NextGen-Environmental-Sensor-Lab/NGENS-Sap-Flow-Sensor-V2.1-bigbox/README.md

<small>

**SAPFLOW SENSOR V2.1 - BIGGER BOX, CIRCULAR 10-PIN CONNECTOR, NEW CPU AND PCB, UPDATED CODE**

**[Setup Procedure](./Sapflow%20bigbox%20setup%20procedure.md)**

| |  |  |  |  |  |  |
| :---- | :---- | ----- | ----- | ----- | ----- | :---- |
| **Last updated: 1-26-26** | **PRICE BREAK POINT: 25** |  |  |  |  |  |
| **Designator** | **Part** | **Supplier** | **q/ system** | **$ per part** | **$ per sensor** | **link** |
| JST-PH 10pin with cable | 2 x 20-pack, tot 40 | Amazon | 1 | 1.13 | 1.13 | [Amazon.com 40Pcs jst ph 2.0 Connectors 10 pin w 20pcs Mini](https://www.amazon.com/40Pcs-Connectors-Connector-Include-Female/dp/B0DMZLGB5D?th=1) |
| Lithium CR1220 3 V batteries | 15-pack, tot 30 | Amazon | 1 | 0.40 | 0.40 | [POWEROWL CR1220 Battery (15-Pack)](https://www.amazon.com/POWEROWL-Capacity-Battery-Batteries-Leak-Free/dp/B09877NBQG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) |
| Li CR2032 battery | 50-pack | Amazon | 1 | 0.32 | 0.32 | [Amazon.com: Granicell CR2032 ...](https://www.amazon.com/dp/B0DKXJCMSZ?ref=fed_asin_title) |
| Battery clip connector 9v-type | 4 count, with jst-ph, tot 32 | Amazon | 1 | 1.60 | 1.60 | [amazon.com OZXNO 4 Pcs 9V Battery Snap to PH 2.0](https://www.amazon.com/gp/product/B0BVFWRJDS/ref=ox_sc_act_title_1?smid=A1TOK94TYI9XUY&th=1) |
| M4 x 8mm pcb screws | 3x 50-pack | Amazon | 4 | 0.58 | 2.30 | [amazon screws](https://www.amazon.com/dp/B0FH1WL1YG?ref=fed_asin_title&th=1) |
| 32gb pny micro sd | 3 packs of 5, 15 tot | Amazon | 0 | 7.34 | 0.00 |  |
| 32gb micro sd card | 5 packs of 3, 15 tot | B\&H | 0 | 11.66 | 0.00 | [PNY 32GB Elite UHS-I microSDHC Memory Card P-SDU32X2U185EL-GE](https://www.bhphotovideo.com/c/product/1313832-REG/pny_technologies_p_sdu32x2u185el_ge_flash_memory_card_microsdhc.html) |
| 32gb microsd combined | add above two | B\&H amaz | 1 | 9.50 | 9.50 |  |
| Microcontroller | Feather RP2040 Adalogger | Digikey | 1 | 14.95 | 14.95 | [https://learn.adafruit.com/assets/139935](https://learn.adafruit.com/assets/139935) |
| header female 12 pos (feather) | PPTC121LFBN-RC | Digikey | 1 | 0.54 | 0.54 | [PPTC121LFBN-RC Sullins Connector Solutions](https://www.digikey.com/en/products/detail/sullins-connector-solutions/PPTC121LFBN-RC/807231) |
| header female 16 pos (feather) | PPTC161LFBN-RC | Digikey | 1 | 0.56 | 0.56 | [PPTC161LFBN-RC Sullins Connector Solutions | Headers, Receptacles, Female Sockets | DigiKey](https://www.digikey.com/en/products/detail/sullins-connector-solutions/PPTC161LFBN-RC/810154) |
| JST-PH 2pin vertical |  | Digikey | 1 | 0.11 | 0.11 | [B2B-PH-K-S JST Sales America Inc. | Headers, Male Pins | DigiKey](https://www.digikey.com/en/products/detail/jst-sales-america-inc/B2B-PH-K-S/926611) |
| 10 Pos circ Conn Plug Female | BU-10BFFA-LL7001 | Digikey | 1 | 11.44 | 11.44 | [digikey.com BU-10BFFA-LL7001](https://www.digikey.com/en/products/detail/amphenol-ltw/BU-10BFFA-LL7001/7102699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) |
| Shipping digikey |  | Digikey | 1 | 0.23 | 0.23 |  |
| 10 Pos Cir Conn Male | BU-10PMMS-LC7001 | Digikey | 0 | 5.30 | 0.00 | [digikey.com BU-10PMMS-LC7001](https://www.digikey.com/en/products/detail/amphenol-ltw/BU-10PMMS-LC7001/7102698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) |
| 10 Pos Cir Conn Male | BU-10PMMS-LC7001 | Newark | 0 | 8.91 | 0.00 | [newark.com bu-10pmms-lc7001](https://www.newark.com/amphenol-ltw/bu-10pmms-lc7001/circular-connector-plug-10-position/dp/47W9551) |
| 10 Pos cir conn combined digikey and newark |  |  | 1 | 7.34 | 7.34 |  |
| PCBA JLBPCB | pcba 30 units | JLBPCB | 1 | 23.12 | 23.12 |  |
| Battery Holder | 10x AA battery holder | Newark | 1 | 2.09 | 2.09 | [28-12573 PRO POWER, Battery Holder, Snap Fit, AA X 10 | Newark Electronics](https://www.newark.com/pro-power/28-12573/battery-sizes-accepted-aa/dp/27W3409) |
| Polycase WH-10-01 | With hole for connector | Polycase | 1 | 24.95 | 24.95 | [https://www.polycase.com/wh-10](https://www.polycase.com/wh-02) |
| Ni-MH 1.2V 2500mAh AA batt | 500-pack \+ 100-pack, tot 600 | Tenergy | 20 | 1.42 | 28.40 | [https://www.eblofficial.com/products/rechargeable-nimh-aa-battery?variant=40668336455762](https://www.eblofficial.com/products/rechargeable-nimh-aa-battery?variant=40668336455762) |
</small>
