NextGen-Environmental-Sensor-Lab/NGENS-Sap-Flow-Sensor-V2.1-bigbox/KiCad_PCB/Assembly_Instructions.md

# Version 2.1 Assembly Instructions

## Required parts

- One Adafruit Feather M0 Adalogger
- One 12-pin female header
- One 12-pin male header
- One 16-pin female header
- One 16-pin male header
- One CR2032 coil cell
- One 9V-style battery clip with leads
- One 10-pin JST PH cable assembly
- One set of waterproof connector

### Battery connector options

Option 1: Use a battery clip with only wires on the other end, and solder it to the board.

Option 2: Use a battery clip with a JST connector on the other end, and a JST connector on the board.

### USB power parts

There are two ways to power the microcontroller -- through the USB port, or directly from the board. If you are using USB power, you will need these additional parts.

- One 2-pin push terminal
- One micro USB "pig-tail"

## Instructions

### ID

Each board is assigned an ID. On the back is a grid of solder jumpers, which are used to tell the microcontroller which board it is on. The ID will be included in the data file.

1. Choose the next sequential ID from the database (TBD).
2. Write the ID in the provided space on both the front and back of the board with a permanent marker.
3. Solder a blob of solder between the two contacts of the corresponding solder jumper pads.

### Power configuration

For USB power input, solder a blob of solder across JP43.

For direct power input, solder a blob of solder across JP41 and JP42.
