NextGen-Environmental-Sensor-Lab/NGENS-Sap-Flow-Sensor-V2.1-bigbox/KiCad_PCB/pcb_V2.1bigbox.pdf

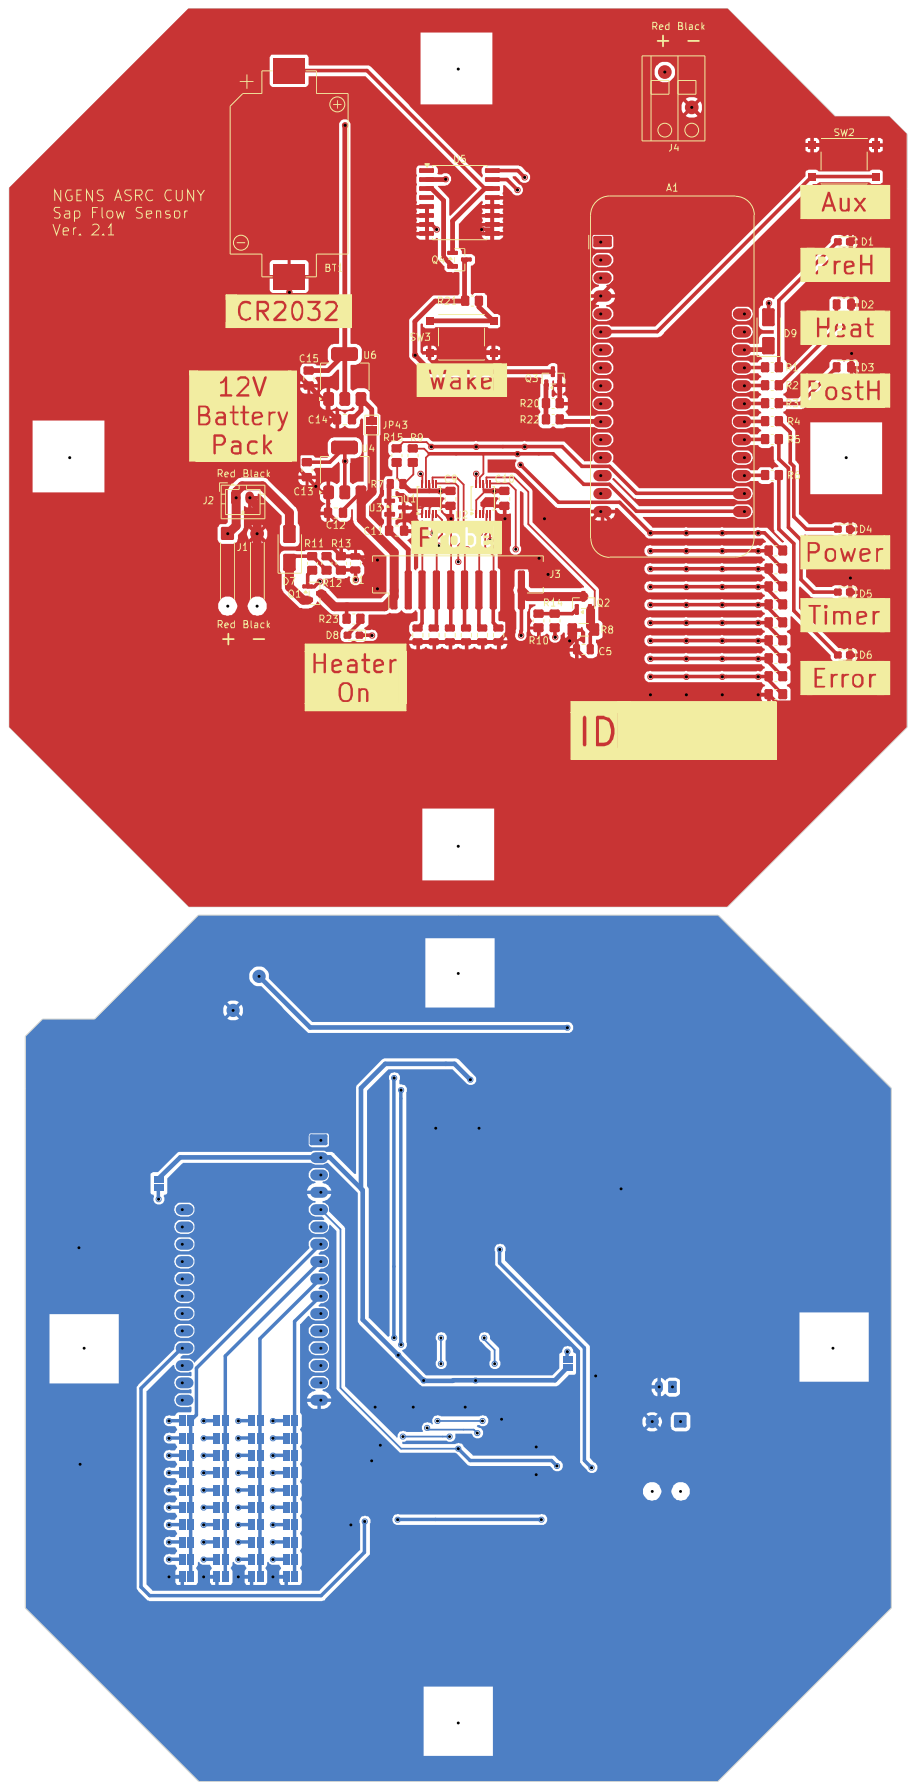
[picture p6: page 1]
