NextGen-Environmental-Sensor-Lab/NGENS-Sap-Flow-Sensor-V2.1-bigbox/KiCad_PCB/SFS.kicad_pcb

## KiCad design KiCad_PCB/SFS.kicad_pcb (2026-06-18)

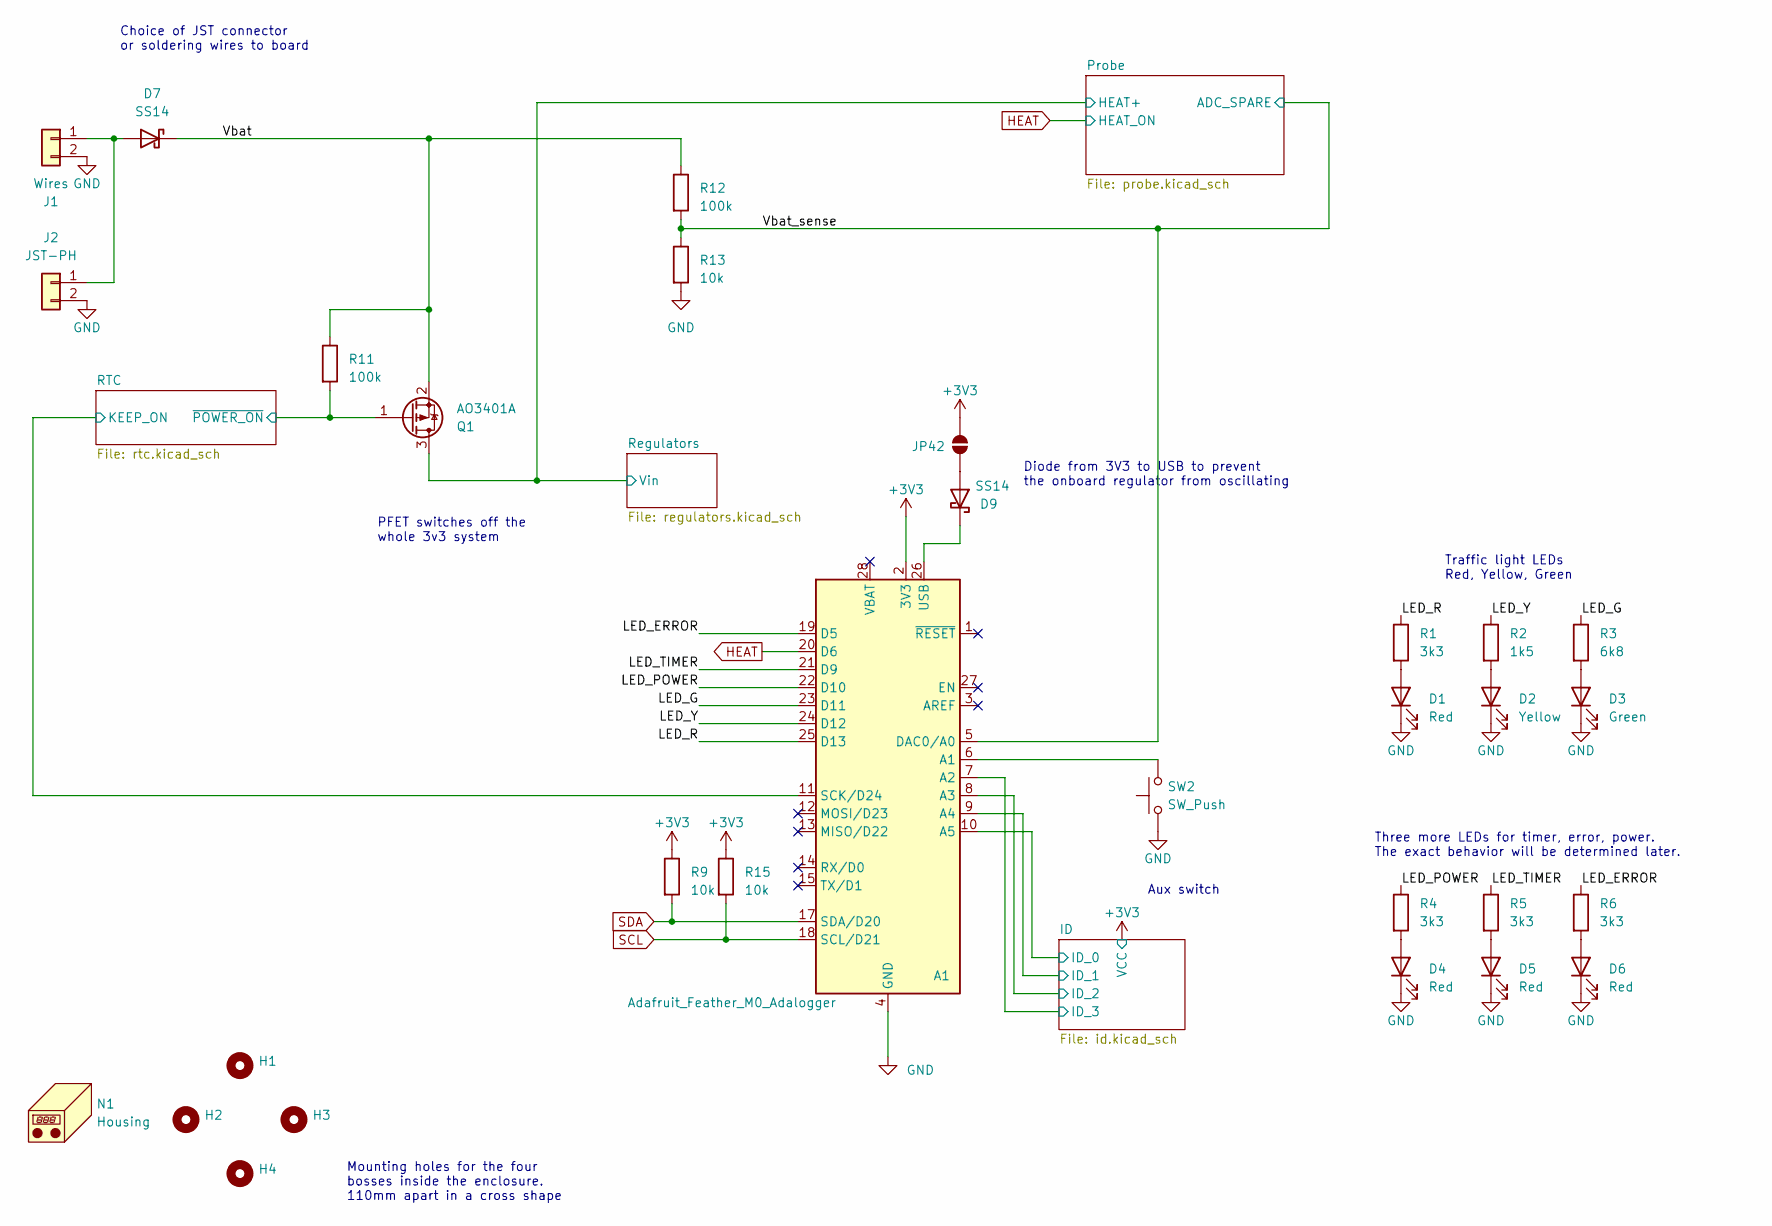
[picture p7: schematic SFS.kicad_sch]

Parts:
A1: Adafruit_Feather_M0_Adalogger; Adafruit_Feather
D1, D4, D5, D6: Red; LED_0603_1608Metric_Pad1.05x0.95mm_HandSolder; LCSC C2286
D2: Yellow; LED_0805_2012Metric_Pad1.15x1.40mm_HandSolder; LCSC C2296
D3: Green; LED_0805_2012Metric_Pad1.15x1.40mm_HandSolder; LCSC C2297
D7, D9: SS14; D_SMA; LCSC C2480
H1, H2, H3, H4: MountingHole; MountingHole_4.3mm_M4
J1: Wires; SolderWire-0.25sqmm_1x02_P4.2mm_D0.65mm_OD1.7mm_Relief
J2: JST-PH; JST_PH_B2B-PH-K_1x02_P2.00mm_Vertical
JP42: SolderJumper_2_Open; SolderJumper-2_P1.3mm_Open_Pad1.0x1.5mm
N1: Housing; Enclosure_WH-10
Q1: AO3401A; SOT-23; LCSC C15127
R1, R4, R5, R6: 3k3; R_0805_2012Metric_Pad1.20x1.40mm_HandSolder; LCSC C26010
R2: 1k5; R_0805_2012Metric_Pad1.20x1.40mm_HandSolder; LCSC C4310
R3: 6k8; R_0805_2012Metric_Pad1.20x1.40mm_HandSolder; LCSC C17772
R9, R13, R15: 10k; R_0805_2012Metric_Pad1.20x1.40mm_HandSolder; LCSC C17414
R11, R12: 100k; R_0805_2012Metric_Pad1.20x1.40mm_HandSolder; LCSC C149504
SW2: SW_Push; SW_Push_1P1T_NO_6x6mm_H9.5mm_C2837532; LCSC C2837532

Connections:
+3V3: A1.2 (3V3), JP42.2 (B), R9.1, R15.1; also elsewhere on the board
/ID/ID_0: A1.10 (A5); also elsewhere on the board
/ID/ID_1: A1.9 (A4); also elsewhere on the board
/ID/ID_2: A1.8 (A3); also elsewhere on the board
/ID/ID_3: A1.7 (A2); also elsewhere on the board
/LED_ERROR: A1.19 (D5), R6.1
/LED_G: A1.23 (D11), R3.1
/LED_POWER: A1.22 (D10), R4.1
/LED_R: A1.25 (D13), R1.1
/LED_TIMER: A1.21 (D9), R5.1
/LED_Y: A1.24 (D12), R2.1
/Probe/HEAT+: Q1.3 (D); also elsewhere on the board
/RTC/KEEP_ON: A1.11 (SCK/D24); also elsewhere on the board
/RTC/~POWER_ON: Q1.1 (G), R11.2; also elsewhere on the board
/Vbat: D7.1 (K), Q1.2 (S), R11.1, R12.1
/Vbat_sense: A1.5 (DAC0/A0), R12.2, R13.1; also elsewhere on the board
GND: A1.4 (GND), A1.16 (GND), D1.1 (K), D2.1 (K), D3.1 (K), D4.1 (K), D5.1 (K), D6.1 (K), J1.2, J2.2, R13.2, SW2.1; also elsewhere on the board
HEAT: A1.20 (D6); also elsewhere on the board
unnamed: A1.6 (A1), SW2.2
unnamed: A1.26 (USB), D9.1 (K)
unnamed: D1.2 (A), R1.2
unnamed: D2.2 (A), R2.2
unnamed: D3.2 (A), R3.2
unnamed: D4.2 (A), R4.2
unnamed: D5.2 (A), R5.2
unnamed: D6.2 (A), R6.2
unnamed: D7.2 (A), J1.1, J2.1
unnamed: D9.2 (A), JP42.1 (A)
SCL: A1.18 (SCL/D21), R15.2; also elsewhere on the board
SDA: A1.17 (SDA/D20), R9.2; also elsewhere on the board

Notes on the sheet:
Mounting holes for the four bosses inside the enclosure. 110mm apart in a cross shape
PFET switches off the whole 3v3 system
Traffic light LEDs Red, Yellow, Green
Diode from 3V3 to USB to prevent the onboard regulator from oscillating
Three more LEDs for timer, error, power. The exact behavior will be determined later.
Aux switch
Choice of JST connector or soldering wires to board

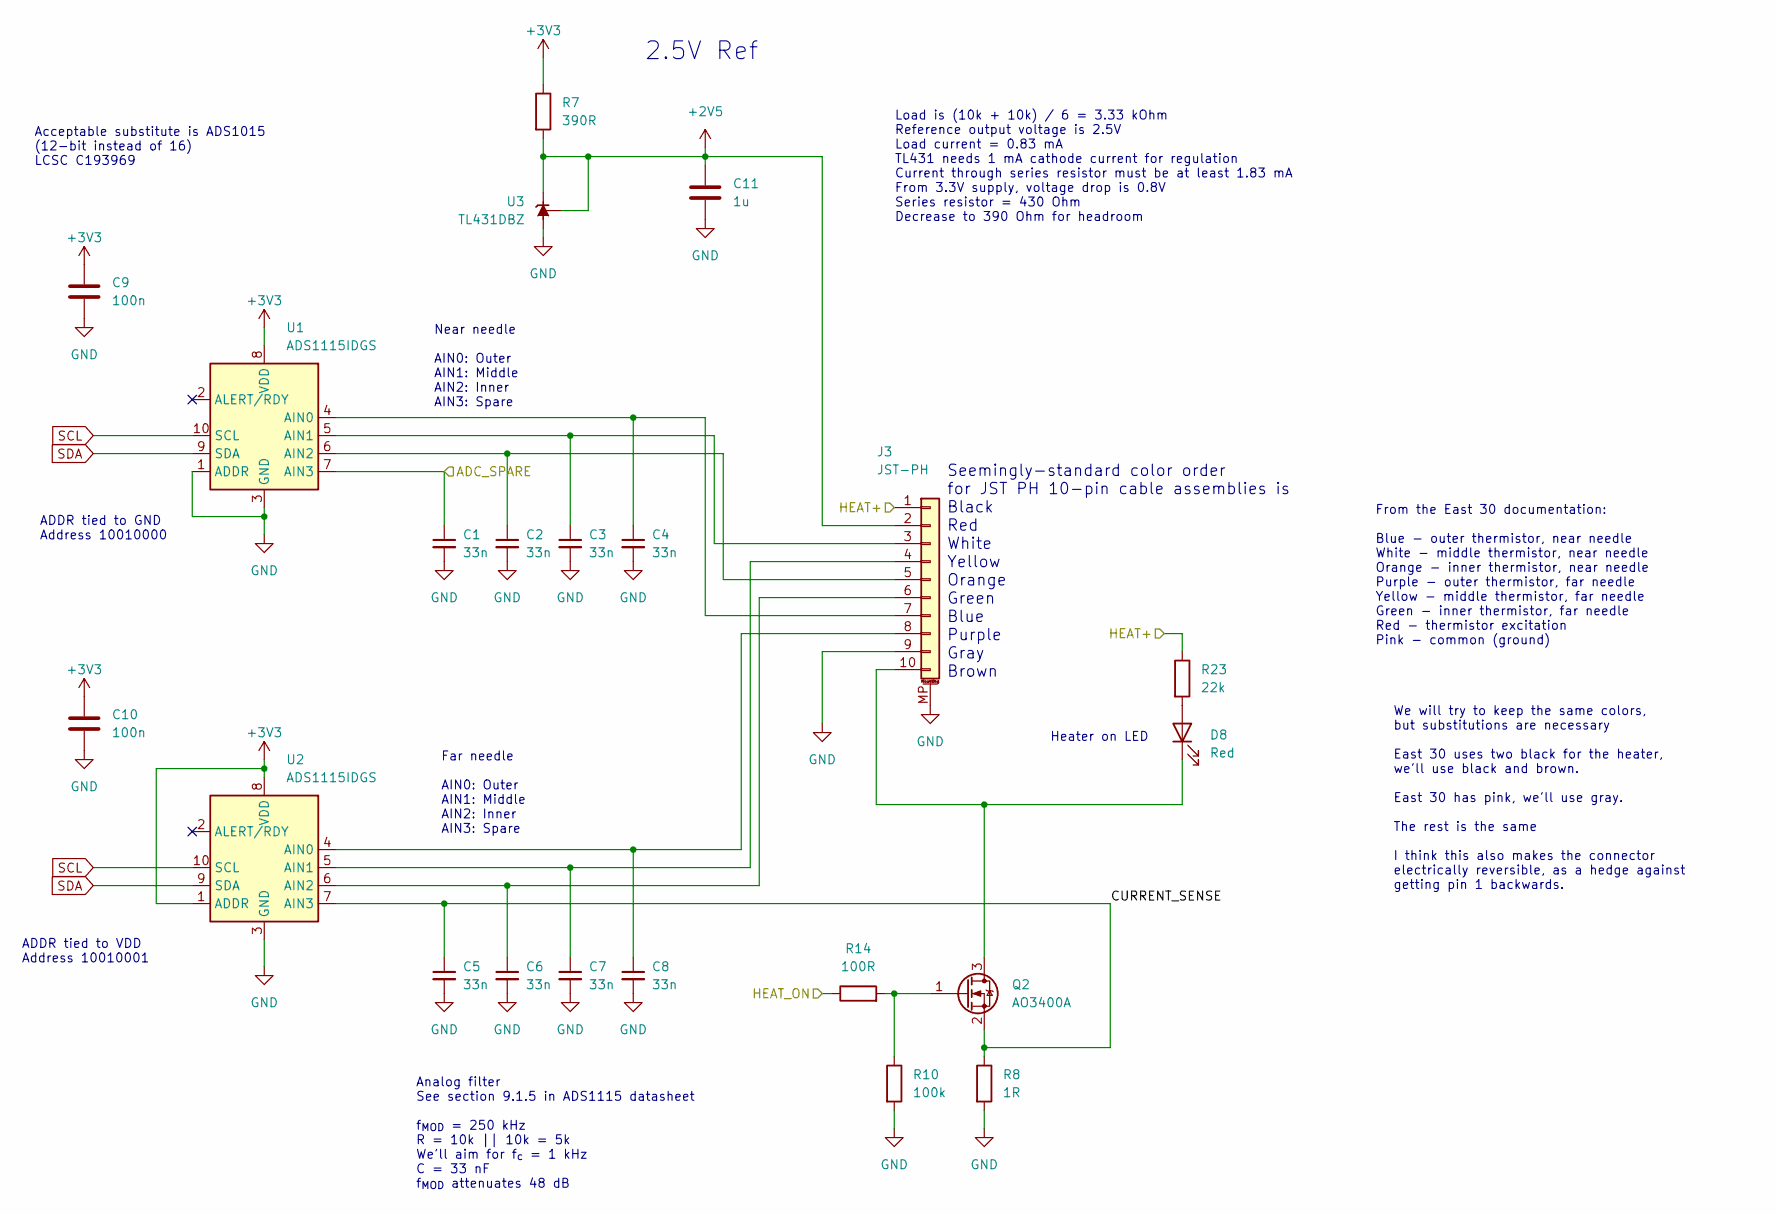
[picture p8: schematic probe.kicad_sch]

Parts:
C1, C2, C3, C4, C5, C6, C7, C8: 33n; C_0805_2012Metric; LCSC C1739
C9, C10: 100n; C_0805_2012Metric_Pad1.18x1.45mm_HandSolder; LCSC C49678
C11: 1u; C_0805_2012Metric_Pad1.18x1.45mm_HandSolder; LCSC C28323
D8: Red; LED_0603_1608Metric_Pad1.05x0.95mm_HandSolder; LCSC C2286
J3: JST-PH; JST_PH_B10B-PH-SM4-TB_1x10-1MP_P2.00mm_Vertical; LCSC C5292583
Q2: AO3400A; SOT-23; LCSC C20917
R7: 390R; R_0805_2012Metric; LCSC C17655
R8: 1R; R_1206_3216Metric_Pad1.30x1.75mm_HandSolder; LCSC C17928
R10: 100k; R_0805_2012Metric_Pad1.20x1.40mm_HandSolder; LCSC C149504
R14: 100R; R_0805_2012Metric_Pad1.20x1.40mm_HandSolder; LCSC C17408
R23: 22k; R_0805_2012Metric_Pad1.20x1.40mm_HandSolder; LCSC C17560
U1, U2: ADS1115IDGS; TSSOP-10_3x3mm_P0.5mm; LCSC C2868291
U3: TL431DBZ; SOT-23; LCSC C3113

Connections:
+2V5: C11.1, J3.2, R7.2, U3.1 (K), U3.2 (REF)
+3V3: C9.1, C10.1, R7.1, U1.8 (VDD), U2.1 (ADDR), U2.8 (VDD); also elsewhere on the board
/Probe/CURRENT_SENSE: C5.1, Q2.2 (S), R8.1, U2.7 (AIN3)
/Probe/HEAT+: J3.1, R23.1; also elsewhere on the board
/Vbat_sense: C1.1, U1.7 (AIN3); also elsewhere on the board
GND: C1.2, C2.2, C3.2, C4.2, C5.2, C6.2, C7.2, C8.2, C9.2, C10.2, C11.2, J3.9, J3.MP (MountPin), R8.2, R10.2, U1.1 (ADDR), U1.3 (GND), U2.3 (GND), U3.3 (A); also elsewhere on the board
HEAT: R14.1; also elsewhere on the board
unnamed: D8.2 (A), R23.2
unnamed: D8.1 (K), J3.10, Q2.3 (D)
unnamed: C3.1, J3.3, U1.5 (AIN1)
unnamed: C7.1, J3.4, U2.5 (AIN1)
unnamed: C2.1, J3.5, U1.6 (AIN2)
unnamed: C6.1, J3.6, U2.6 (AIN2)
unnamed: C4.1, J3.7, U1.4 (AIN0)
unnamed: C8.1, J3.8, U2.4 (AIN0)
unnamed: Q2.1 (G), R10.1, R14.2
SCL: U1.10 (SCL), U2.10 (SCL); also elsewhere on the board
SDA: U1.9 (SDA), U2.9 (SDA); also elsewhere on the board

Notes on the sheet:
ADDR tied to GND Address 10010000
Acceptable substitute is ADS1015 (12-bit instead of 16) LCSC C193969
Far needle AIN0: Outer AIN1: Middle AIN2: Inner AIN3: Spare
Near needle AIN0: Outer AIN1: Middle AIN2: Inner AIN3: Spare
2.5V Ref
Heater on LED
Load is (10k + 10k) / 6 = 3.33 kOhm Reference output voltage is 2.5V Load current = 0.83 mA TL431 needs 1 mA cathode current for regulation Current through series resistor must be at least 1.83 mA From 3.3V supply, voltage drop is 0.8V Series resistor = 430 Ohm Decrease to 390 Ohm for headroom
From the East 30 documentation: Blue - outer thermistor, near needle White - middle thermistor, near needle Orange - inner thermistor, near needle Purple - outer thermistor, far needle Yellow - middle thermistor, far needle Green - inner thermistor, far needle Red - thermistor excitation Pink - com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
We will try to keep the same colors, but substitutions are necessary East 30 uses two black for the heater, we'll use black and brown. East 30 has pink, we'll use gray. The rest is the same I think this also makes the connector electrically reversible, as a hedge against getting pin 1 backwards.
Analog filter See section 9.1.5 in ADS1115 datasheet f_{MOD} = 250 kHz R = 10k || 10k = 5k We'll aim for f_{c} = 1 kHz C = 33 nF f_{MOD} attenuates 48 dB
Seemingly-standard color order for JST PH 10-pin cable assemblies is Black Red White Yellow Orange Green Blue Purple Gray Brown
ADDR tied to VDD Address 10010001

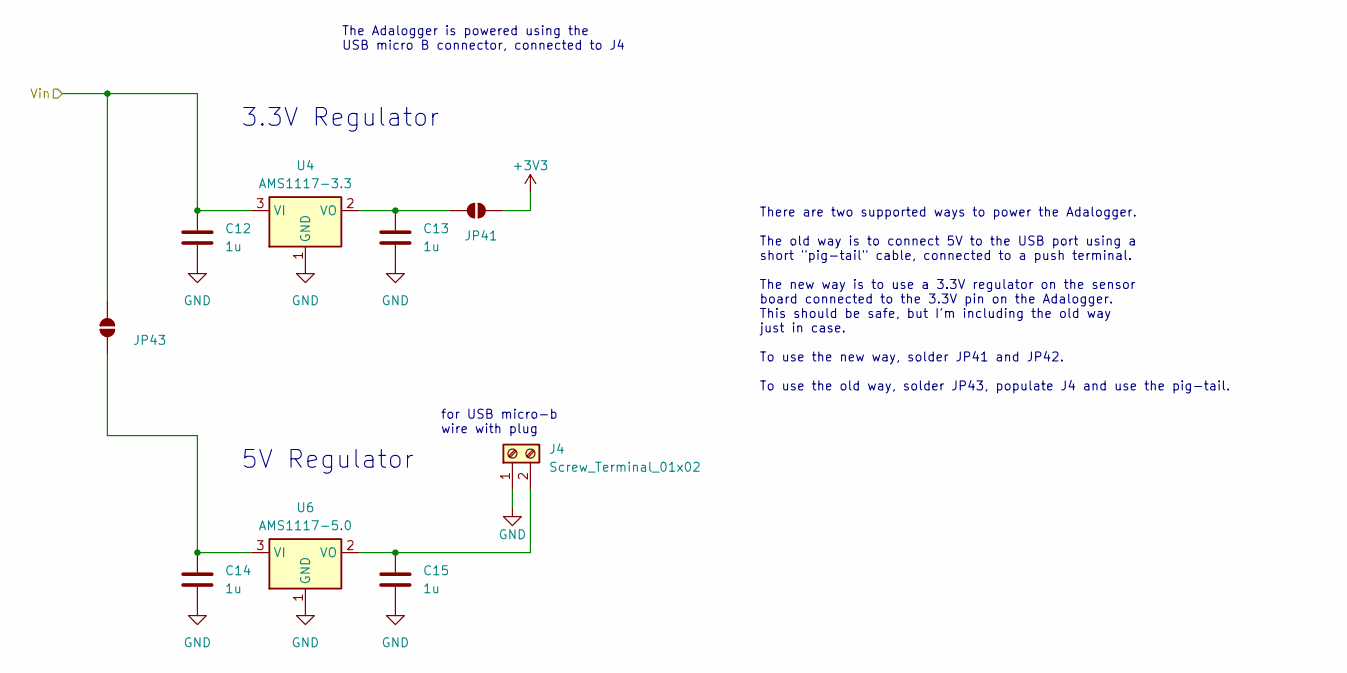
[picture p9: schematic regulators.kicad_sch]

Parts:
C12, C13, C14, C15: 1u; C_0805_2012Metric_Pad1.18x1.45mm_HandSolder; LCSC C28323
J4: Screw_Terminal_01x02; Wurth_Screwless45_3.81mm_2
JP41, JP43: SolderJumper_2_Open; SolderJumper-2_P1.3mm_Open_Pad1.0x1.5mm
U4: AMS1117-3.3; SOT-223-3_TabPin2; LCSC C6186
U6: AMS1117-5.0; SOT-223-3_TabPin2; LCSC C6187

Connections:
+3V3: JP41.1 (A); also elsewhere on the board
/Probe/HEAT+: C12.1, JP43.1 (A), U4.3 (VI); also elsewhere on the board
GND: C12.2, C13.2, C14.2, C15.2, J4.1, U4.1 (GND), U6.1 (GND); also elsewhere on the board
unnamed: C15.1, J4.2, U6.2 (VO)
unnamed: C13.1, JP41.2 (B), U4.2 (VO)
unnamed: C14.1, JP43.2 (B), U6.3 (VI)

Notes on the sheet:
There are two supported ways to power the Adalogger. The old way is to connect 5V to the USB port using a short "pig-tail" cable, connected to a push terminal. The new way is to use a 3.3V regulator on the sensor board connected to the 3.3V pin on the Adalogger. This should be safe, but I'm includi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
5V Regulator
The Adalogger is powered using the USB micro B connector, connected to J4
for USB micro-b wire with plug
3.3V Regulator

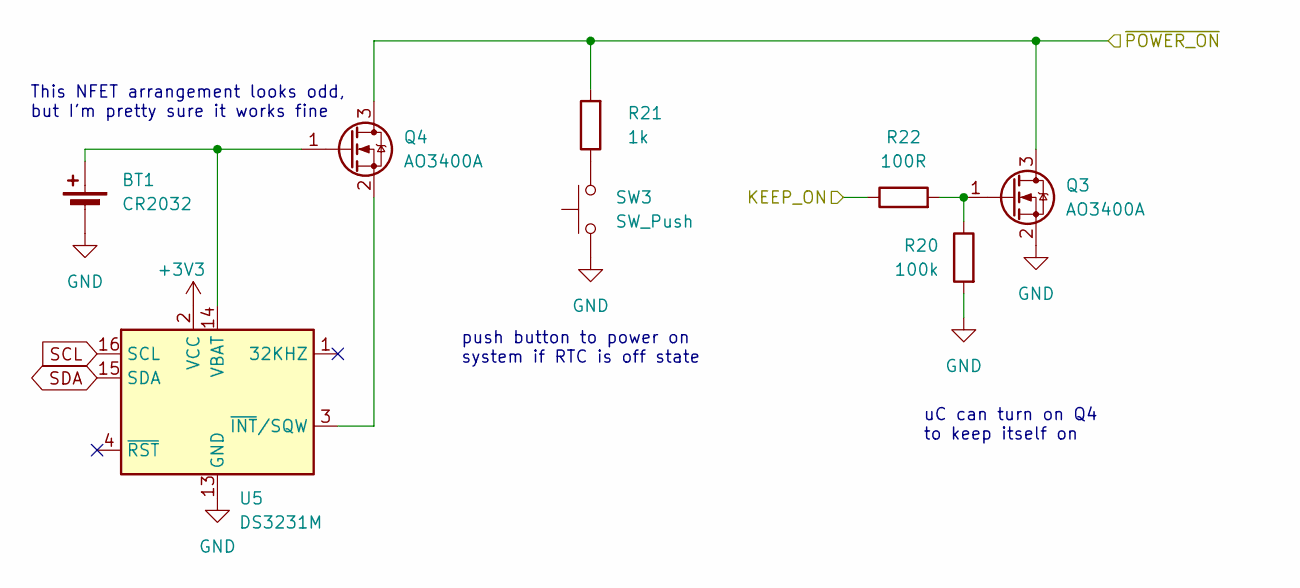
[picture p10: schematic rtc.kicad_sch]

Parts:
BT1: CR2032; BatteryHolder_MYOUNG_C964760_1x2032; LCSC C964760
Q3, Q4: AO3400A; SOT-23; LCSC C20917
R20: 100k; R_0805_2012Metric_Pad1.20x1.40mm_HandSolder; LCSC C149504
R21: 1k; R_0805_2012Metric_Pad1.20x1.40mm_HandSolder; LCSC C17513
R22: 100R; R_0805_2012Metric_Pad1.20x1.40mm_HandSolder; LCSC C17408
SW3: SW_Push; SW_Push_1P1T_NO_6x6mm_H9.5mm_C2837532; LCSC C2837532
U5: DS3231M; SOIC-16W_7.5x10.3mm_P1.27mm; LCSC C9866

Connections:
+3V3: U5.2 (VCC); also elsewhere on the board
/RTC/KEEP_ON: R22.1; also elsewhere on the board
/RTC/~POWER_ON: Q3.3 (D), Q4.3 (D), R21.2; also elsewhere on the board
GND: BT1.2 (-), Q3.2 (S), R20.2, SW3.1, U5.5 (GND), U5.6 (GND), U5.7 (GND), U5.8 (GND), U5.9 (GND), U5.10 (GND), U5.11 (GND), U5.12 (GND), U5.13 (GND); also elsewhere on the board
unnamed: BT1.1 (+), Q4.1 (G), U5.14 (VBAT)
unnamed: Q3.1 (G), R20.1, R22.2
unnamed: Q4.2 (S), U5.3 (~INT/SQW)
unnamed: R21.1, SW3.2
SCL: U5.16 (SCL); also elsewhere on the board
SDA: U5.15 (SDA); also elsewhere on the board

Notes on the sheet:
This NFET arrangement looks odd, but I'm pretty sure it works fine
uC can turn on Q4 to keep itself on
push button to power on system if RTC is off state

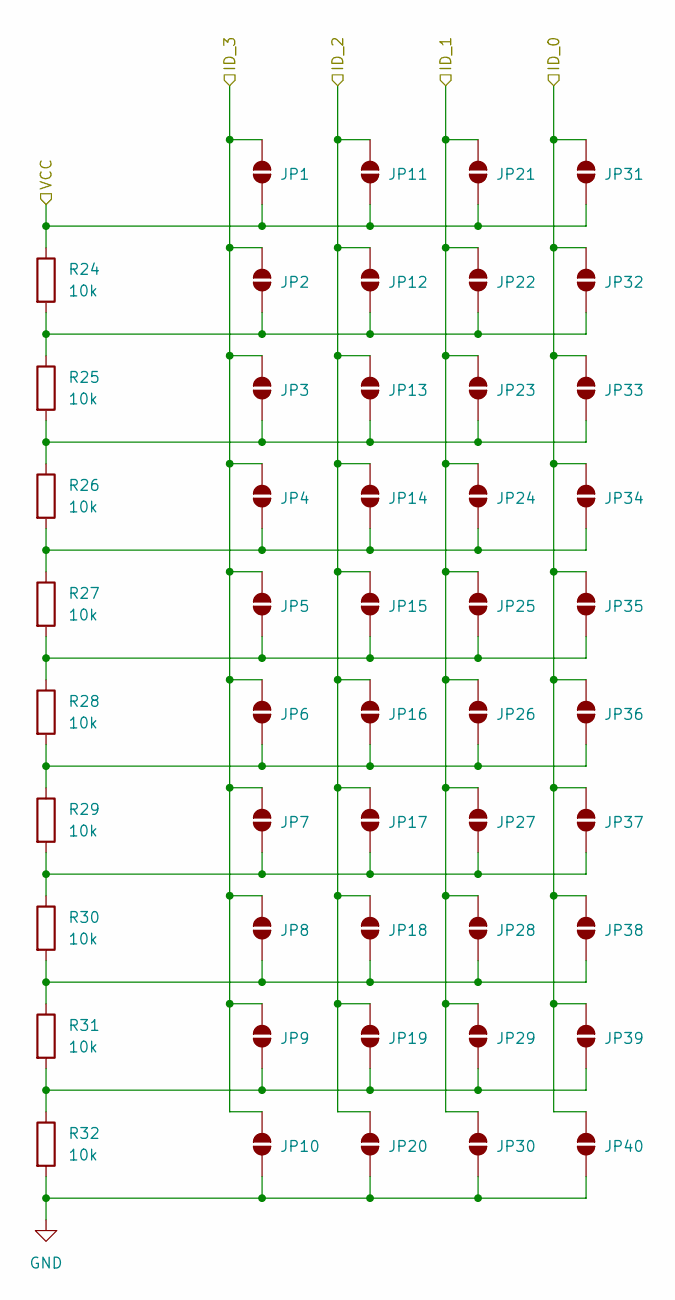
[picture p11: schematic id.kicad_sch]

Parts:
JP1, JP2, JP3, JP4, JP5, JP6, JP7, JP8, JP9, JP10, JP11, JP12, JP13, JP14, JP15, JP16, JP17, JP18, JP19, JP20, JP21, JP22, JP23, JP24, JP25, JP26, JP27, JP28, JP29, JP30, JP31, JP32, JP33, JP34, JP35, JP36, JP37, JP38, JP39, JP40: SolderJumper_2_Open; SolderJumper-2_P1.3mm_Open_Pad1.0x1.5mm
R24, R25, R26, R27, R28, R29, R30, R31, R32: 10k; R_0805_2012Metric_Pad1.20x1.40mm_HandSolder; LCSC C17414

Connections:
+3V3: JP1.1 (A), JP11.1 (A), JP21.1 (A), JP31.1 (A), R24.1; also elsewhere on the board
/ID/ID_0: JP31.2 (B), JP32.2 (B), JP33.2 (B), JP34.2 (B), JP35.2 (B), JP36.2 (B), JP37.2 (B), JP38.2 (B), JP39.2 (B), JP40.2 (B); also elsewhere on the board
/ID/ID_1: JP21.2 (B), JP22.2 (B), JP23.2 (B), JP24.2 (B), JP25.2 (B), JP26.2 (B), JP27.2 (B), JP28.2 (B), JP29.2 (B), JP30.2 (B); also elsewhere on the board
/ID/ID_2: JP11.2 (B), JP12.2 (B), JP13.2 (B), JP14.2 (B), JP15.2 (B), JP16.2 (B), JP17.2 (B), JP18.2 (B), JP19.2 (B), JP20.2 (B); also elsewhere on the board
/ID/ID_3: JP1.2 (B), JP2.2 (B), JP3.2 (B), JP4.2 (B), JP5.2 (B), JP6.2 (B), JP7.2 (B), JP8.2 (B), JP9.2 (B), JP10.2 (B); also elsewhere on the board
GND: JP10.1 (A), JP20.1 (A), JP30.1 (A), JP40.1 (A), R32.2; also elsewhere on the board
unnamed: JP2.1 (A), JP12.1 (A), JP22.1 (A), JP32.1 (A), R24.2, R25.1
unnamed: JP3.1 (A), JP13.1 (A), JP23.1 (A), JP33.1 (A), R25.2, R26.1
unnamed: JP4.1 (A), JP14.1 (A), JP24.1 (A), JP34.1 (A), R26.2, R27.1
unnamed: JP5.1 (A), JP15.1 (A), JP25.1 (A), JP35.1 (A), R27.2, R28.1
unnamed: JP6.1 (A), JP16.1 (A), JP26.1 (A), JP36.1 (A), R28.2, R29.1
unnamed: JP7.1 (A), JP17.1 (A), JP27.1 (A), JP37.1 (A), R29.2, R30.1
unnamed: JP8.1 (A), JP18.1 (A), JP28.1 (A), JP38.1 (A), R30.2, R31.1
unnamed: JP9.1 (A), JP19.1 (A), JP29.1 (A), JP39.1 (A), R31.2, R32.1

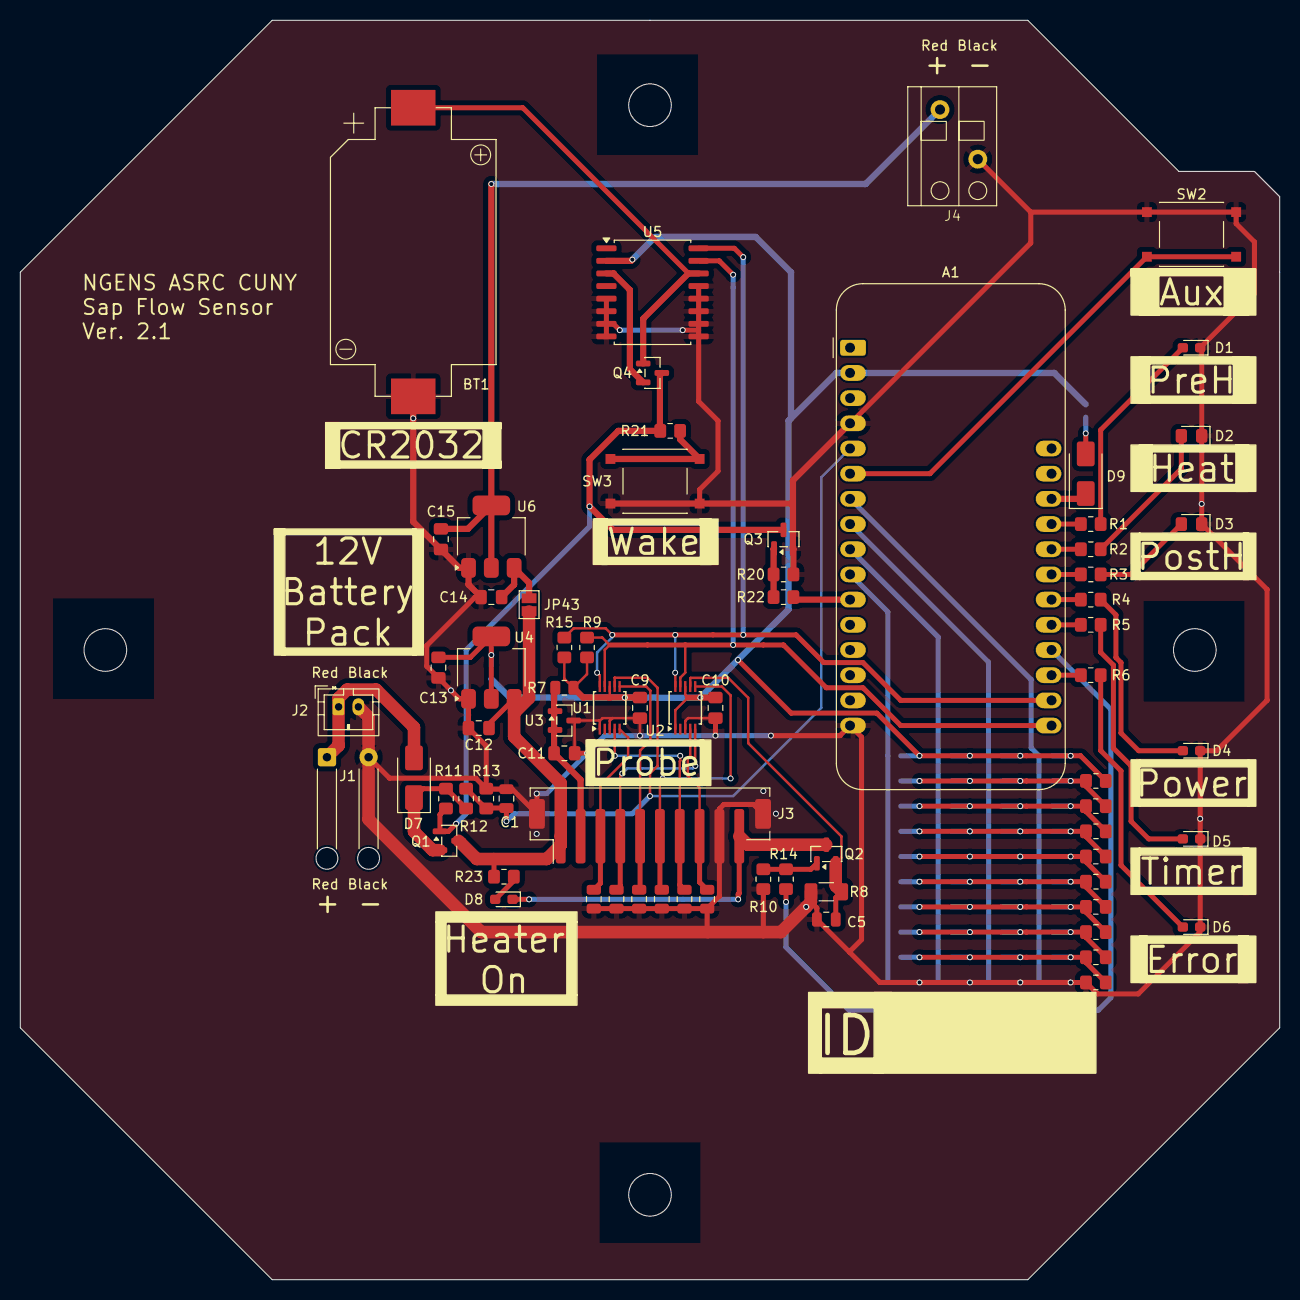
[picture p12: board SFS.kicad_pcb from above]

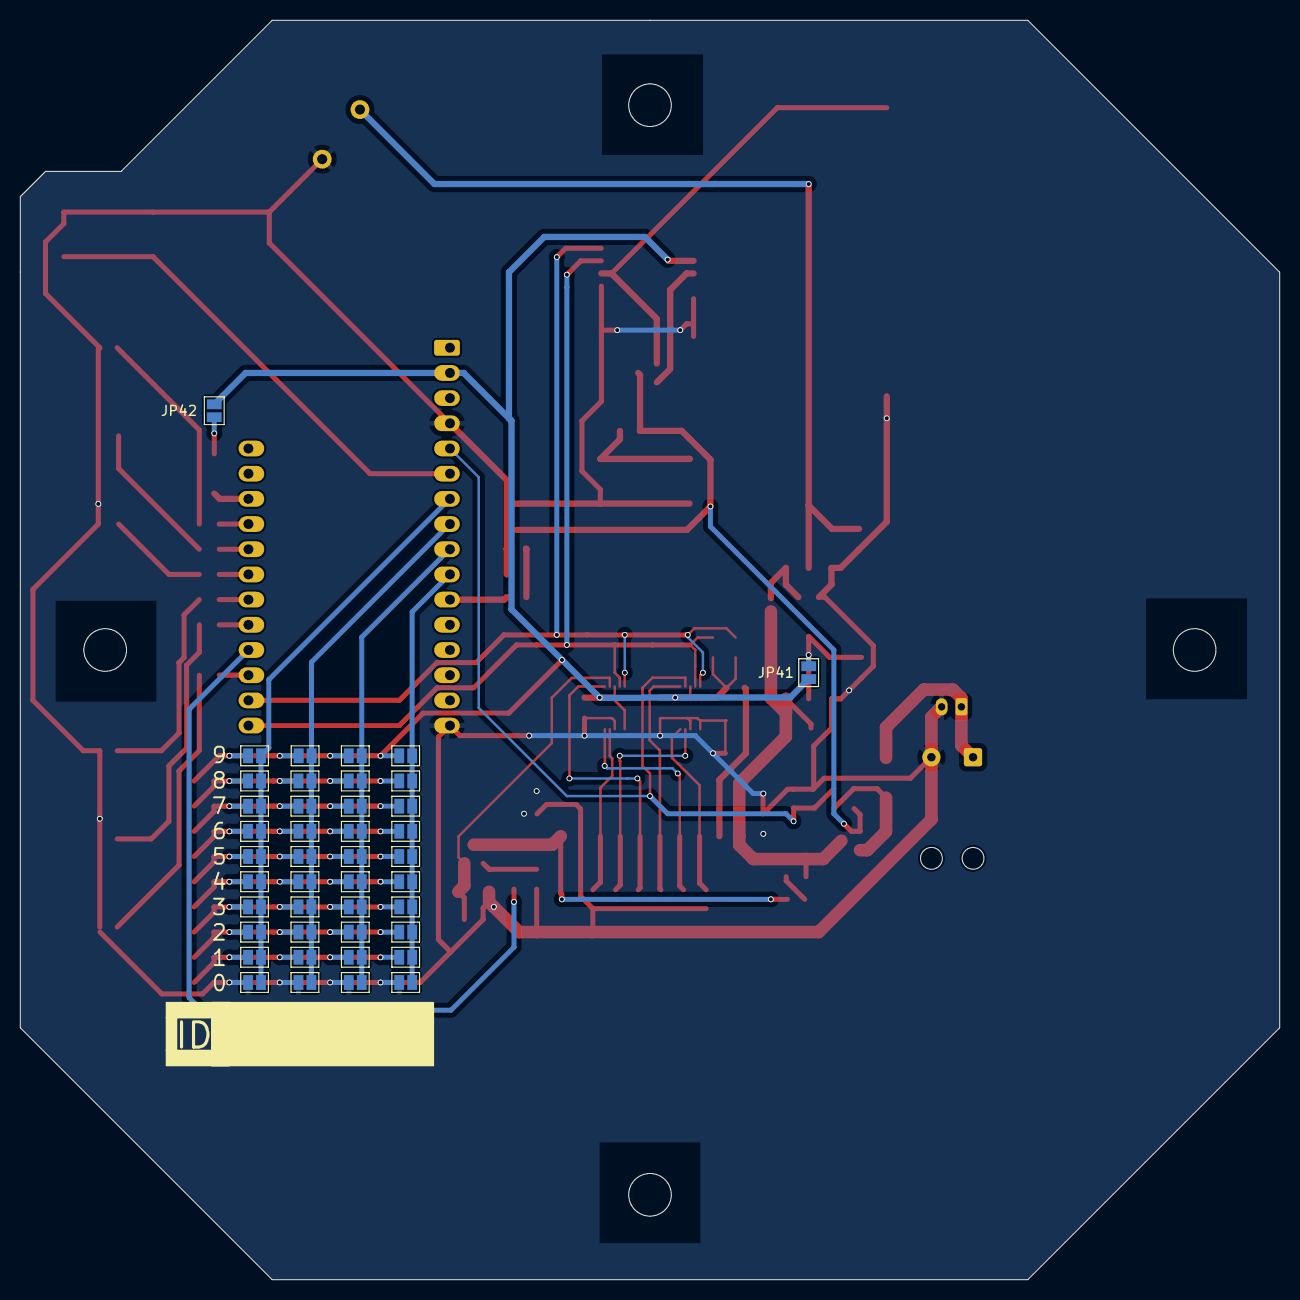
[picture p13: board SFS.kicad_pcb from below]

Board: 2 copper layers, 127.0 x 127.0 mm, 118 parts (42 on the bottom side), 56 nets.
