NextGen-Environmental-Sensor-Lab/NGENS-Sap-Flow-Sensor-V2.1-bigbox/(commit log)

2026-04-07 Add initial README for NGENS v2.1 sap flow sensor
2026-04-07 multiple cleanups
    missing: id function
    [ds3231_test2.ino, functions.ino, sap_flow2.ino]
2026-04-10 major update
    added provisioning and many Claude suggestions and fixes
    [ds3231_test2.ino, functions.ino, provisioning.ino, sap_flow2.ino]
2026-04-10 minor fixes
    Wire.end and begin,
    [functions.ino, sap_flow2.ino, sfs_config.h]
2026-04-13 some bugs fixd
    removed wire waits. they didn't help with the 'cant find RTC' and made it worse. Also added checkProvisioning() in the error loop.
    [functions.ino, sap_flow2.ino]
2026-04-17 added pcb
    Added Stefan's pcb design.
    [SFS.kicad_pcb, SFS.kicad_sch, analog.kicad_sch]
2026-04-17 renamed KiCad_PCB
    [SFS.kicad_pcb, SFS.kicad_sch, analog.kicad_sch]
2026-06-18 updated kicad
    Updated to v2.1 from evonne's github
    [SFS.kicad_pcb, SFS.kicad_sch, analog.kicad_sch, bom.csv, id.kicad_sch, positions.csv, probe.kicad_sch, regulators.kicad_sch]
